norly/amiga-mmkeyboard-pic12f629-pcb/Amiga-PCB-MMKeyboard-PIC12F629.kicad_pcb

## KiCad design Amiga-PCB-MMKeyboard-PIC12F629.kicad_pcb (2025-06-15)

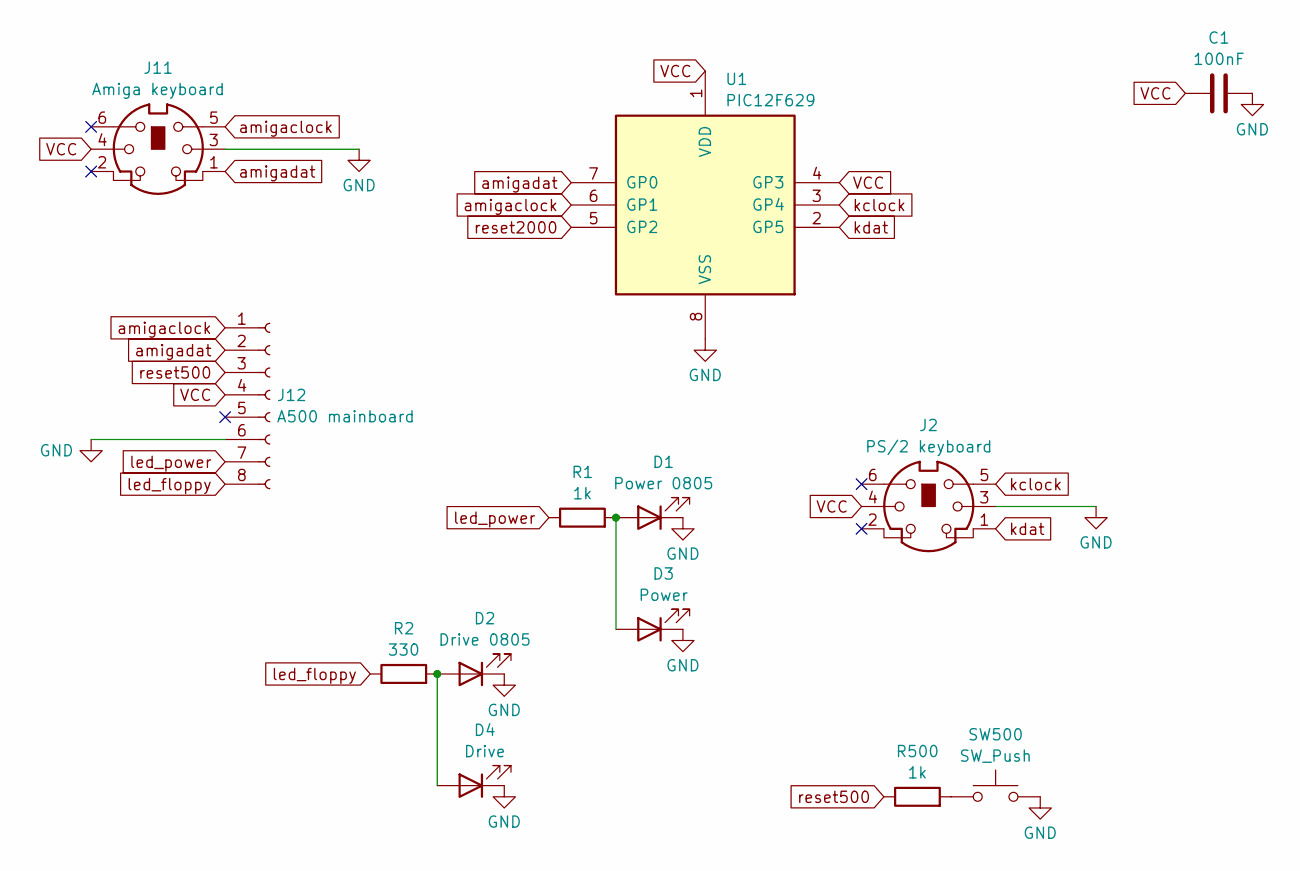
[picture p1: schematic Amiga-PCB-MMKeyboard-PIC12F629.kicad_sch]

Parts:
C1: 100nF; C_0805_2012Metric_Pad1.18x1.45mm_HandSolder; JLCPCB C49678
D1: Power 0805; LED_0805_2012Metric_Pad1.15x1.40mm_HandSolder; JLCPCB C2297
D2: Drive 0805; LED_0805_2012Metric_Pad1.15x1.40mm_HandSolder; JLCPCB C2296
D3: Power; LED_D3.0mm
D4: Drive; LED_D3.0mm
J2: PS/2 keyboard; Mini-DIN-6_PS2-Keyboard-Socket_Connfly_DS1093-01-PN60; LCSC C77848
J11: Amiga keyboard; Mini-DIN-6_PS2-Keyboard-Socket_Connfly_DS1093-01-PN60; LCSC C77848
J12: A500 mainboard; PinSocket_1x08_P2.54mm_Vertical; LCSC C2685213
R1, R500: 1k; R_0805_2012Metric_Pad1.20x1.40mm_HandSolder; JLCPCB C17513
R2: 330; R_0805_2012Metric_Pad1.20x1.40mm_HandSolder; JLCPCB C17630
SW500: SW_Push; PinHeader_1x02_P2.54mm_Horizontal; LCSC C7501290
U1: PIC12F629; DIP-8_W7.62mm; LCSC C72124

Connections:
GND: C1.2, D1.1 (K), D2.1 (K), D3.1 (K), D4.1 (K), J2.3, J11.3, J12.6, SW500.1, U1.8 (VSS)
unnamed: D1.2 (A), D3.2 (A), R1.2
unnamed: D2.2 (A), D4.2 (A), R2.2
unnamed: R500.2, SW500.2
VCC: C1.1, J2.4, J11.4, J12.4, U1.1 (VDD), U1.4 (GP3)
amigaclock: J11.5, J12.1, U1.6 (GP1)
amigadat: J11.1, J12.2, U1.7 (GP0)
kclock: J2.5, U1.3 (GP4)
kdat: J2.1, U1.2 (GP5)
led_floppy: J12.8, R2.1
led_power: J12.7, R1.1
reset500: J12.3, R500.1
reset2000: U1.5 (GP2)

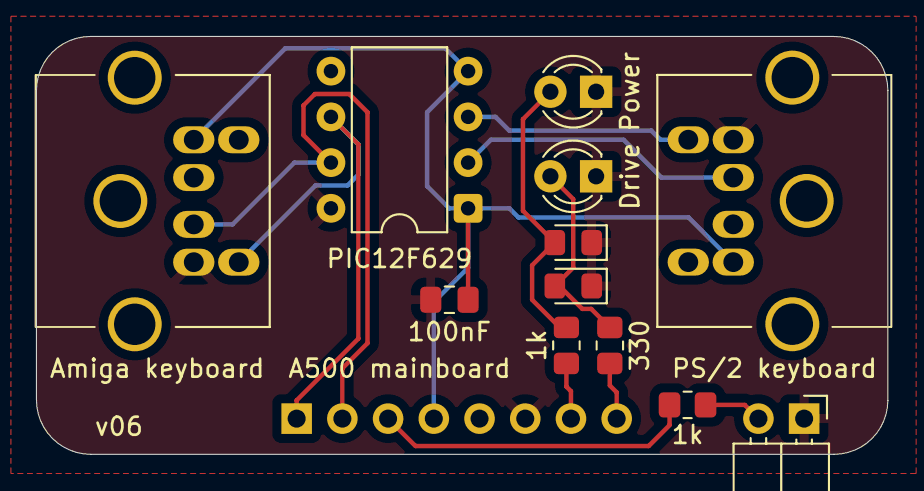
[picture p2: board Amiga-PCB-MMKeyboard-PIC12F629.kicad_pcb from above]

Board: 2 copper layers, 47.3 x 23.2 mm, 13 parts (1 on the bottom side), 12 nets.
