norly/amiga-mmkeyboard-pic12f629-pcb/(commit log)

2024-01-14 v02
    - Update PS/2 socket footprint
    - Print "values" on silkscreen
    - Add 100 nF for PIC
    - Shorten "values"
    - Move things to the left for more space and to balance the look
    [Amiga-PCB-MMKeyboard-PIC12F629.kicad_pcb, Amiga-PCB-MMKeyboard-PIC12F629.kicad_sch]
2024-01-25 v03: Fix mirrored pin numbering on PS/2 (Mini DIN 6) connectors
    The previous versions couldn't actually work due to a mistake in the
    Mini DIN 6 connector footprint.
    [Amiga-PCB-MMKeyboard-PIC12F629.kicad_pcb]
2024-03-06 v04: Change resistors to 470 Ohm, late A500 LED colours
    200 Ohm are the original value seen on an A500 keyboard, but with modern
    0805 LEDs this ends up too bright.
    The JLCPCB/LCSC part numbers for the SMD LEDs are now:
    - Power: green
    - Drive: yellow
    [Amiga-PCB-MMKeyboard-PIC12F629.kicad_pcb, Amiga-PCB-MMKeyboard-PIC12F629.kicad_sch]
2024-03-10 Add Reichelt order numbers
    [Amiga-PCB-MMKeyboard-PIC12F629.kicad_sch]
2024-05-31 v05: Fix A500 interface, add A500 reset button
    The A500 part was untested.
    - data/clock were swapped
    - reset was wrongly connected to the PIC
    Added a jumper to reset an A500.
    [Amiga-PCB-MMKeyboard-PIC12F629.kicad_pcb, Amiga-PCB-MMKeyboard-PIC12F629.kicad_sch]
2025-06-15 KiCad 9.0 and add local copy of Mini-DIN-6 socket footprint
    [Amiga-PCB-MMKeyboard-PIC12F629.kicad_pcb, Amiga-PCB-MMKeyboard-PIC12F629.kicad_sch]
2025-06-15 v06: Sane LED resistor values depending on the LED's properties
    [Amiga-PCB-MMKeyboard-PIC12F629.kicad_pcb, Amiga-PCB-MMKeyboard-PIC12F629.kicad_sch]
